jjakob/amprot/notes.txt

PB2 = 3.4V (power not ok, mute off)
      -0.4V (power ok, mute off)
      4.5V (mute on)

PB4 = 0V (amp fail)
      1.5V (temp 65 deg C) ADC 76
      1.74V (temp 60 deg C) ADC 86
