jjakob/amprot/prototype/index.md

Main board (C2 is SMD on underside of board; R20, Q5/Q6/C4/R12 omitted)
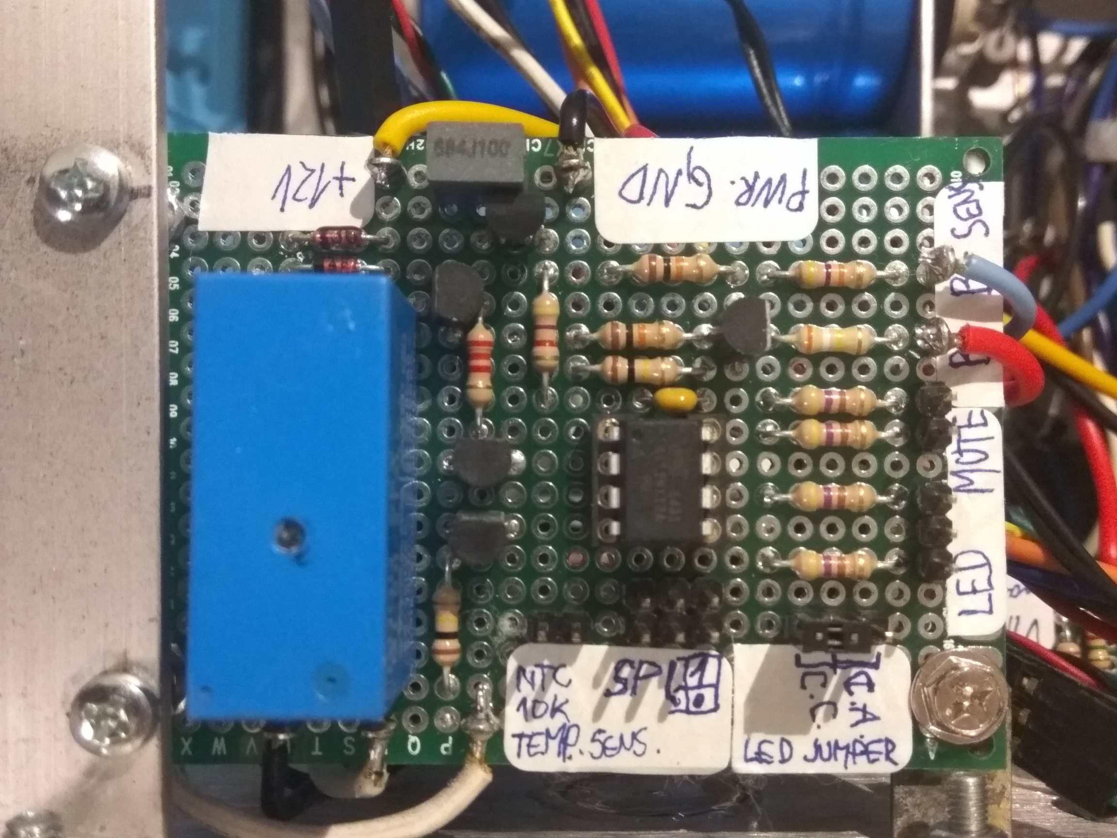
[picture p1: prototype/board.jpg]

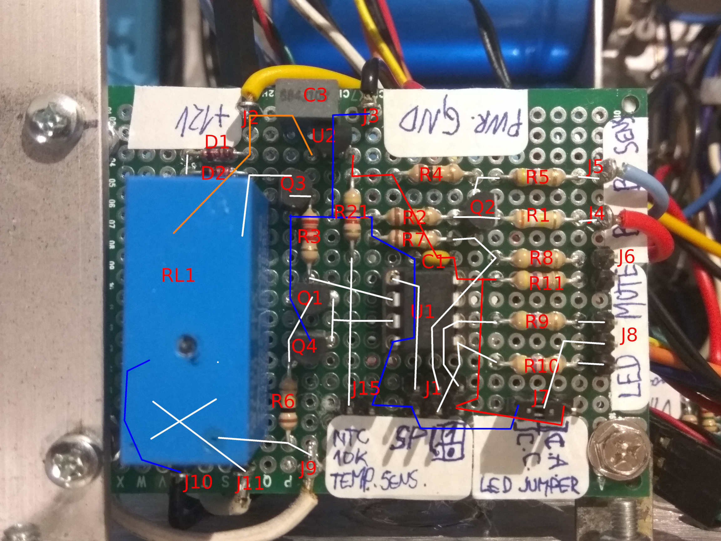
[picture p2: prototype/board_annotated_nets.jpg]

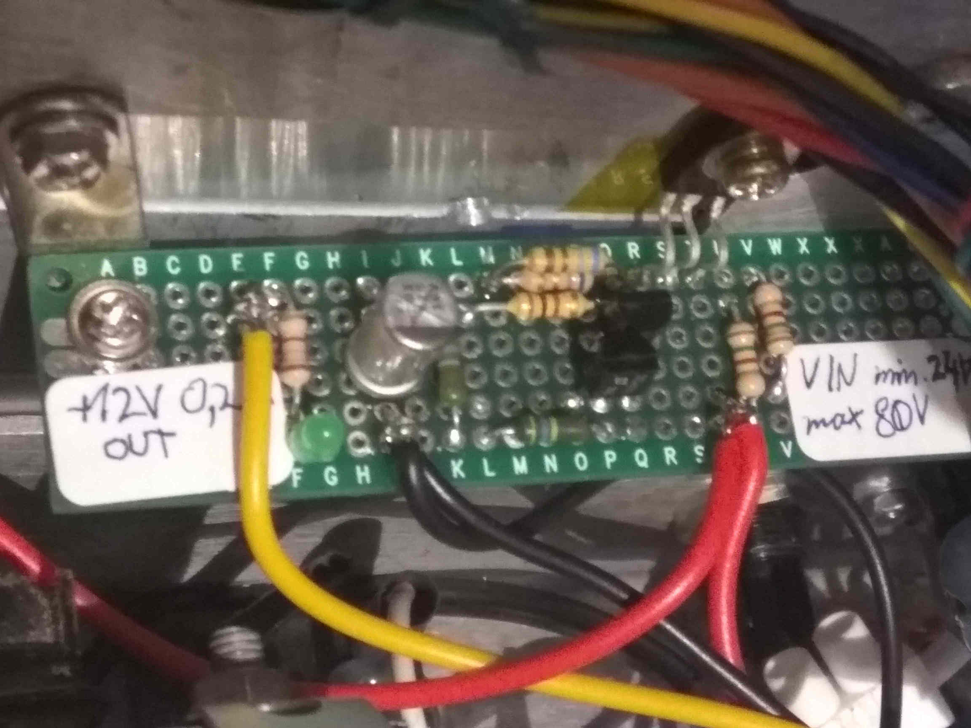
[picture p3: prototype/preregulator.jpg]
