jjakob/amprot/amprot_v1/amprot_v1.pdf

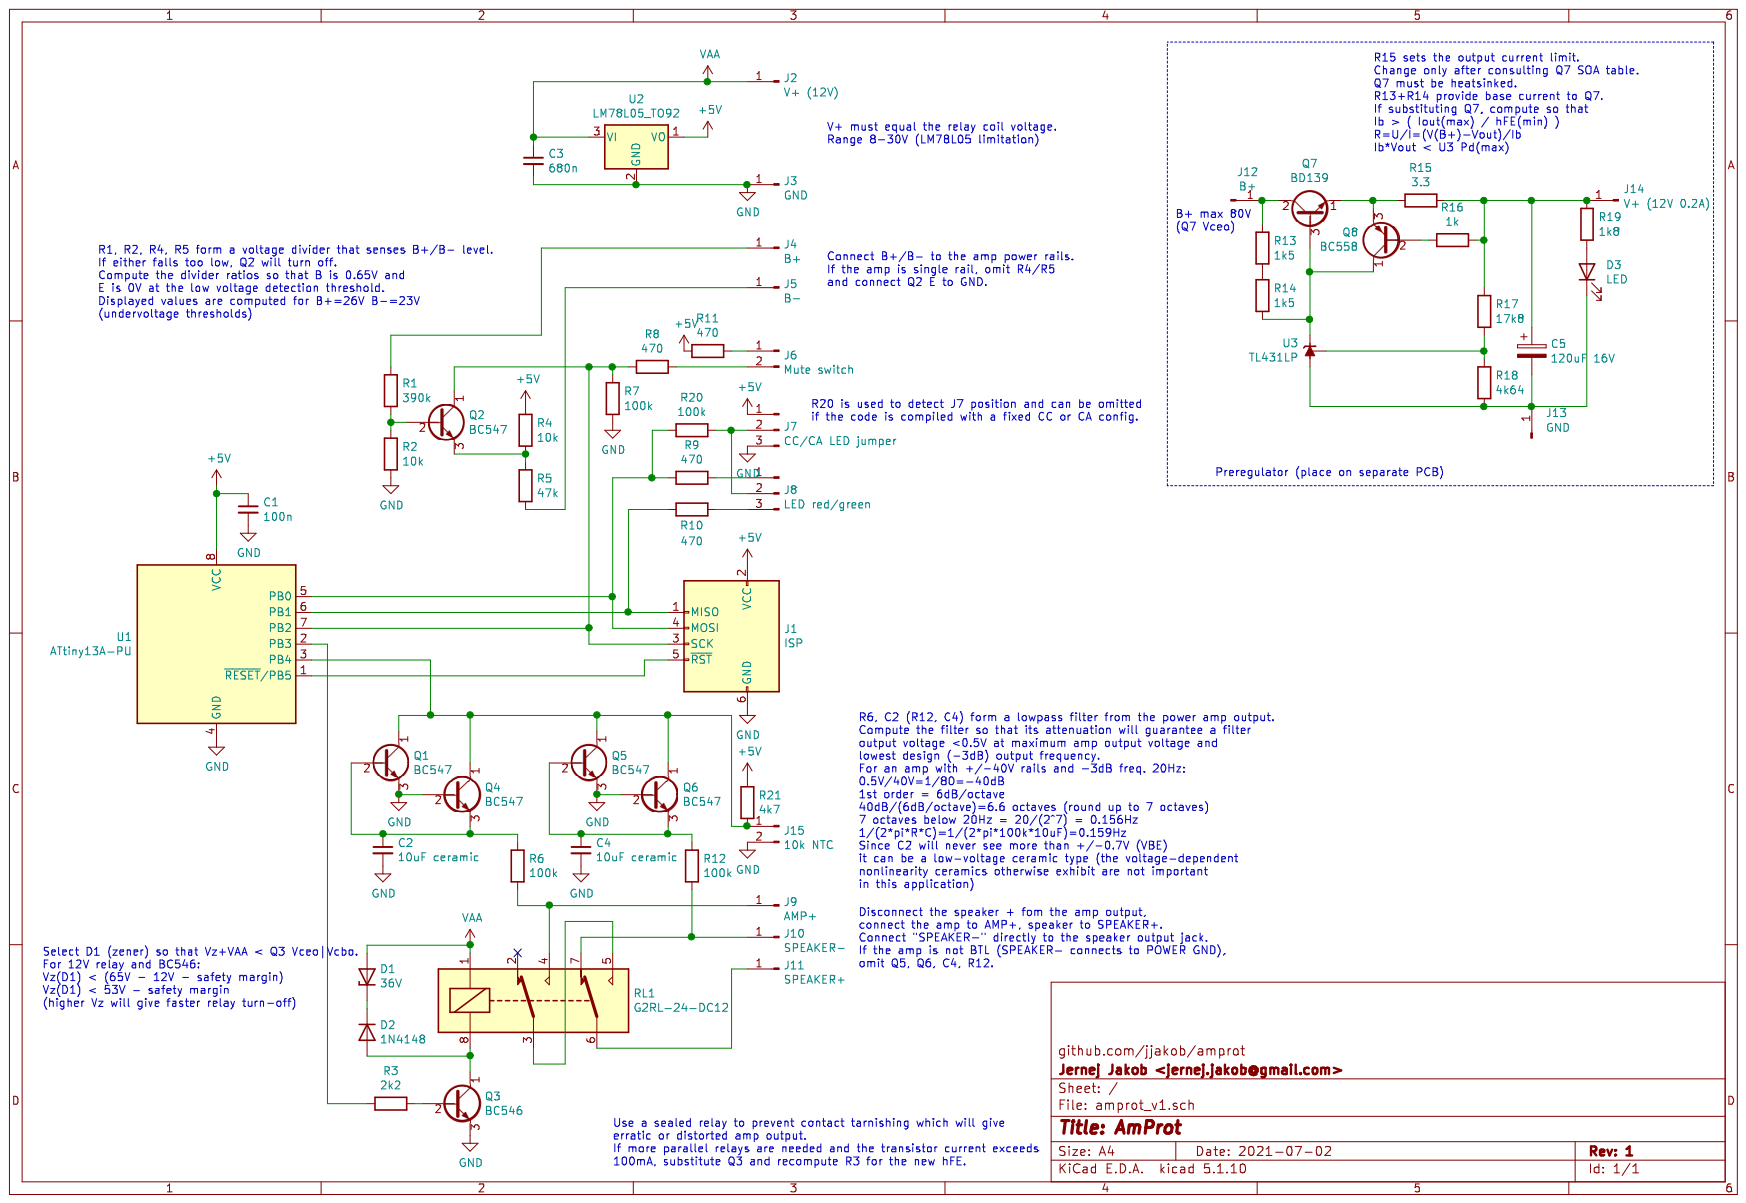
[picture p4: page 1]
