jjakob/amprot/(commit log)

2021-06-30 Makefile: fix device type
    avrdude and avr-gcc have different device names for the same device.
2021-06-30 Makefile: add readcal target that reads calibration from signature
2021-06-30 Test delay.h
    Uses avr-libc util/delay.h.
    Set CKSEL to 4.8MHz, disable prescaler in CKDIV8.
    Since OSCCAL is not initialized by the micro at reset (only for 9.6MHz)
    use the read value from cal.hex to set it in the program.
    [main.c]
2021-07-01 Change OSCCAL in small steps
    The datasheet says OSCCAL should not be changed more than 0x20 at a
    time. To do this, compute the difference between wanted and current
    OSCCAL and increment/decrement it in 0xf (16)-sized steps with 10us
    delays in between.
2021-07-01 State machine and ADC conversion
2021-07-01 Move ADC thresholds to defines and add hysteresis
2021-07-01 Relay output, delay and LED blinking
2021-07-01 Add watchdog timer with 15ms timeout
2021-07-01 Add temperature values to notes
2021-07-01 README: add information on relay
2021-07-01 README: fix allowed supply voltage
2021-07-02 Add schematic v1
    [amprot_v1.kicad_pcb, amprot_v1.sch]
2021-07-02 README: add links to schematic
2021-07-02 Fix errors in schematic
    Q8 B was not connected. Add note on B+ max voltage and V+ max current.
    [amprot_v1.sch]
2021-07-02 Add missing NTC and pullup
    [amprot_v1.sch]
2021-07-02 Add prototype images
2021-07-02 Add prototype images page
